athi94/sunswift.driver-display/hardware/addl-pcb-flipped.pdf

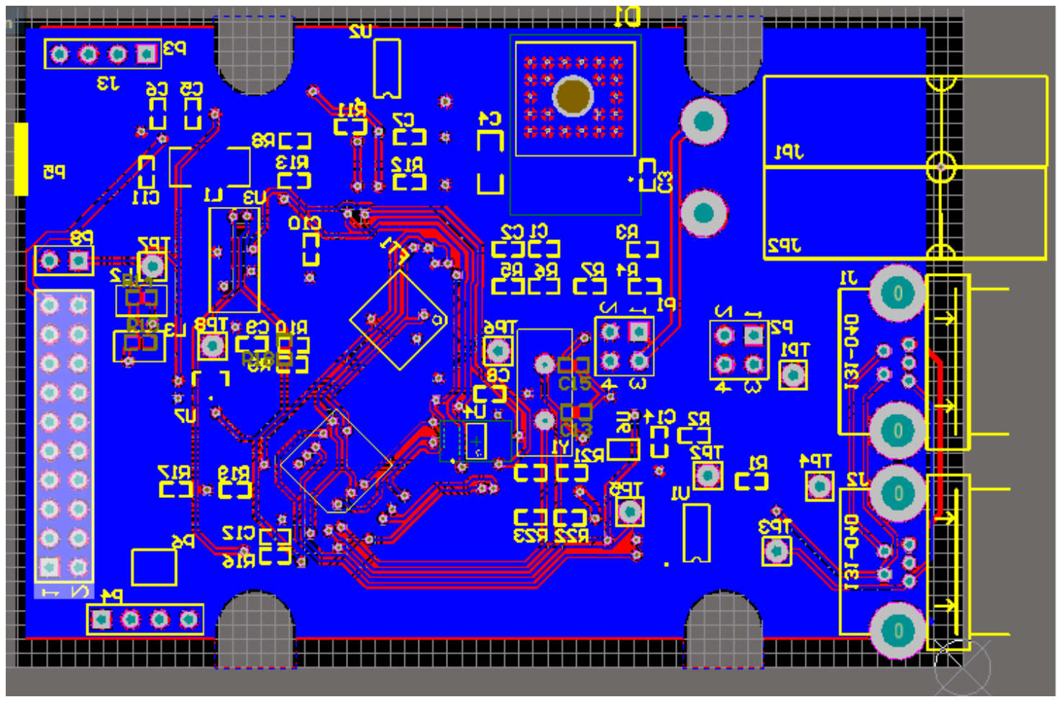
[picture p1: page 1]
