athi94/sunswift.driver-display/hardware/addl-pcb.pdf

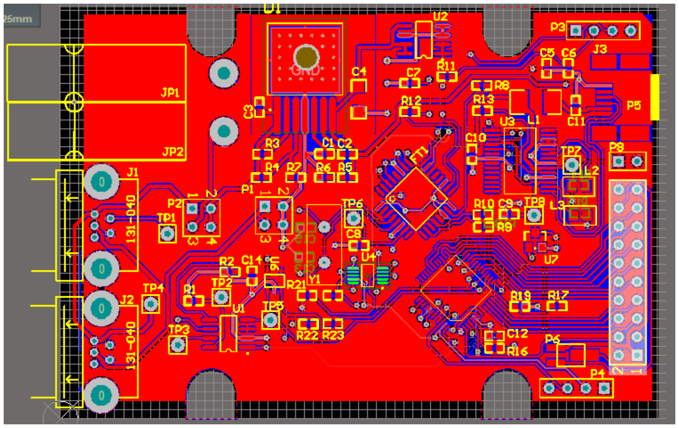
[picture p2: page 1]
