athi94/sunswift.driver-display/hardware/addl-placement-v1-20130409.bmp

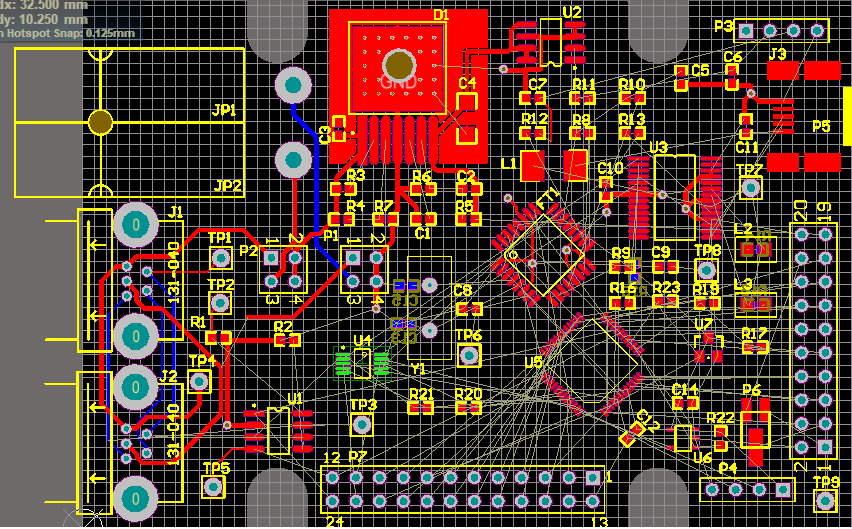
hardware/addl-placement-v1-20130409.bmp
