athi94/sunswift.driver-display/hardware/bom/bom.xlsx

Sheet: combined-20130705
Comment | Description | Footprint | LibRef | Quantity/board | Quantity for 3 boards each | Status
CAP | Ceramic Capacitor (100uF) | 1206 | CAP | 3 | 9 | Not in Inventory
CAP | Capacitor (10uF) | 1206 |  | 1 | 3 | Not in Inventory
INDUCTOR | Inductor | 1812 | INDUCTOR | 2 | 6 | Not in Inventory
Male Break away Headers | Male Break away Headers | - | - | 3 | 9 | Not in Inventory
Female Breakaway headers | Female Breakaway headers | - | - | 3 | 9 | Not in Inventory
MIC5200 | MIC5200 - SO8 | SO8 | MIC5200 | 1 | 3 | Not in Inventory
Dual Analog Switches for FT311D signals selection | Ultra-low resistance dual SPDT Analog switch | MICRO10 | NLAS4684 | 3 | 9 | Not in Inventory
24AAXX | I2C EEPROM for SOT23-5 package | SOT23-5 | 24AAXX | 2 | 6 | Not in Inventory
XC61CN2002MR | SOT23 reset generator | SOT23-3 | XC61F | 2 | 6 | Not in Inventory
XBEE HEADERS | 2mm spacing, 20 pins headers for xbee | XBEE_HEADER | XBEE PRO 900HP | 2 | 6 | Not in Inventory
Male Right angle headers required (6x) 1x20 each |  | - | - | 2 | 6 | Not in Inventory
SD card data logger from sparkfun |  | - | - | 1 | 3 | Not in Inventory

Sheet: driver-display-20130705
Comment | Description | Designator | Footprint | LibRef | Quantity | Status
~~CAP~~ | ~~Capacitor~~ | ~~C1, C2, C3, C5, C6, C7, C8, C9, C10, C11, C12, C13, C14, C15, C16, C17, C18~~ | ~~603~~ | ~~CAP, CAP1~~ | ~~17~~ | ~~In Inventory~~
CAP | Capacitor | C4 | 1206 | CAP | 1
~~DC-DC SWITCHER~~ | ~~DC-DC SWITCHER~~ | ~~D1~~ | ~~PFM-7~~ | ~~lmz12001~~ | ~~1~~ | ~~In Inventory~~
~~FT311D~~ | ~~USB ANDROID Host IC~~ | ~~FT1~~ | ~~QFP32~~ | ~~FT311D~~ | ~~1~~ | ~~Not required atm~~
~~HOLE~~ | ~~Hole~~ | ~~H2, H4~~ | ~~M2.5~~ | ~~HOLE~~ | ~~2~~ | ~~Not part~~
~~CON5-S~~ | ~~Connector, 2 pin, with shield @ S~~ | ~~J1, J2~~ | ~~TRIAD5F~~ | ~~CON5-S~~ | ~~2~~ | ~~Getting for free and salvaged some?~~
~~USB_MINIB~~ | ~~USB Mini B Connector~~ | ~~J3~~ | ~~USBMINIB~~ | ~~USB_miniB_SMT~~ | ~~1~~ | ~~In Inventory~~
~~PGND~~ | ~~Power Ground (currently assumed that it is provided through a min-anderson connector)~~ | ~~JP1~~ | ~~POWERPOLE25A~~ | ~~CON1~~ | ~~1~~ | ~~In Inventory~~
~~CON1~~ | ~~Currently assumed that the mini-anderson connector provides 12V~~ | ~~JP2~~ | ~~POWERPOLE25A~~ | ~~CON1~~ | ~~1~~ | ~~In Inventory~~
INDUCTOR | Inductor | L1 | 1812 | INDUCTOR | 1
~~LED~~ |  | ~~L2, L3~~ | ~~0805LED~~ | ~~LED~~ | ~~2~~ | ~~In Inventory~~
~~LED for Blink Testing~~ |  | ~~L4~~ | ~~0805LED~~ | ~~LED~~ | ~~1~~ | ~~In Inventory~~
Header 2X2 | Header, 2-Pin, Dual row | P1, P2 | HDR2X2 | Header 2X2 | 2
Header 4 | Header, 4-Pin | P3, P4 | HDR1X4 | Header 4 | 2
~~RES1~~ | ~~Resistor~~ | ~~R1, R3, R4, R5, R6, R7, R9, R12, R13, R14, R15, R20, R21, R24, R25~~ | ~~603~~ | ~~RES1~~ | ~~15~~ | ~~In Inventory~~
~~For normal operation, ground AB. To implement autobaud, pull AB high.~~ | ~~Resistor~~ | ~~R2~~ | ~~603~~ | ~~RES1~~ | ~~1~~ | ~~In Inventory~~
~~Leave Open for SPI(Slave)~~ | ~~Resistor~~ | ~~R8~~ | ~~603~~ | ~~RES1~~ | ~~1~~ | ~~In Inventory~~
~~Leave open for UART~~ | ~~Resistor~~ | ~~R10~~ | ~~603~~ | ~~RES1~~ | ~~1~~ | ~~In Inventory~~
~~27~~ | ~~Resistor~~ | ~~R11~~ | ~~603~~ | ~~RES1~~ | ~~1~~ | ~~In Inventory~~
~~Res Semi~~ | ~~Semiconductor Resistor~~ | ~~R16, R17, R18, R19, R22, R23~~ | ~~603~~ | ~~Res Semi~~ | ~~6~~ | ~~In Inventory~~
TP_CAN_SIG | TEST POINT for 12V on CAN | TP1 | TESTPOINT | TEST | 1
TEST | TEST POINT | TP2 | TESTPOINT | TEST | 1
TP_CAN_H | TEST POINT | TP3 | TESTPOINT | TEST | 1
TP_RX | TEST POINT | TP5 | TESTPOINT | TEST | 1
TP_AVCC | TEST POINT | TP6 | TESTPOINT | TEST | 1
TP_USB5V | TEST POINT | TP7 | TESTPOINT | TEST | 1
TP_USB3V3 | TEST POINT | TP8 | TESTPOINT | TEST | 1
SN65HVD235. LPC can pull Rs Hi for standby mode | 3.3V CAN XCVR W/STANDBY | U1 | SO8 | SN65HVD235 | 1 | In Inventory
MIC5200 | MIC5200 - SO8 | U2 | SO8 | MIC5200 | 1
FT232R |  | U3 | SSOP28w | FT232R | 1 | In Inventory
Dual Analog Switches for FT311D signals selection | Ultra-low resistance dual SPDT Analog switch | U4 | MICRO10 | NLAS4684 | 2
LPC11C14 | NXP LPC11C14 Microcontroller | U5 | QFP48 | LPC11C14_Full | 1 | In Inventory
24AAXX | I2C EEPROM for SOT23-5 package | U6 | SOT23-5 | 24AAXX | 1
XC61CN2002MR | SOT23 reset generator | U7 | SOT23-3 | XC61F | 1
12 MHz | Crystal | Y1, Y2 | HC49/4H | CRYSTAL | 2 | In Inventory

Sheet: telemetry-20130705
Comment | Description | Designator | Footprint | LibRef | Quantity | Status
~~CAP~~ | ~~Capacitor~~ | ~~C1, C2, C6, C7, C8, C9, C10, C11~~ | ~~603~~ | ~~CAP~~ | ~~8~~ | ~~In Inventory~~
CAP | Capacitor | C3, C4 | 1206 | CAP | 2
~~100nF~~ | ~~Capacitor~~ | ~~C5, C12, C13, C14~~ | ~~603~~ | ~~CAP~~ | ~~4~~ | ~~In Inventory~~
~~DC-DC SWITCHER~~ | ~~DC-DC SWITCHER~~ | ~~D1~~ | ~~PFM-7~~ | ~~lmz12001~~ | ~~1~~ | ~~In Inventory~~
HOLE | Hole | H2, H4 | M2.5 | HOLE | 2
~~CON5-S~~ | ~~Connector, 2 pin, with shield @ S~~ | ~~J1, J2~~ | ~~TRIAD5F~~ | ~~CON5-S~~ | ~~2~~ | ~~Salvaged - In Inventory~~
~~USB_MINIB~~ | ~~USB Mini B Connector~~ | ~~J3~~ | ~~USBMINIB~~ | ~~USB_miniB_SMT~~ | ~~1~~ | ~~In Inventory~~
~~CON1~~ | ~~Currently assumed that the mini-anderson connector provides 12V~~ | ~~JP1~~ | ~~POWERPOLE25A~~ | ~~CON1~~ | ~~1~~ | ~~In Inventory~~
~~PGND~~ | ~~Power Ground (currently assumed that it is provided through a min-anderson connector)~~ | ~~JP2~~ | ~~POWERPOLE25A~~ | ~~CON1~~ | ~~1~~ | ~~In Inventory~~
INDUCTOR | Inductor | L1 | 1812 | INDUCTOR | 1
~~LED~~ |  | ~~L2, L3, L4, L5, L6~~ | ~~0805LED~~ | ~~LED~~ | ~~5~~ | ~~In Inventory~~
Header 2X2 | Header, 2-Pin, Dual row | P1, P2 | HDR2X2 | Header 2X2 | 2
Header 10X2 | Header, 10-Pin, Dual row | P3 | HDR2X10 | Header 10x2 | 1
Header 4 | Header, 4-Pin | P4 | HDR1X4 | Header 4 | 1
~~RES1~~ | ~~Resistor~~ | ~~R1, R2, R4, R5, R6, R7, R8, R13, R14, R15, R16, R17, R18, R19, R20, R21, R22~~ | ~~603~~ | ~~RES1~~ | ~~17~~ | ~~In Inventory~~
~~Res Semi~~ | ~~Semiconductor Resistor~~ | ~~R3, R9, R10, R11, R12~~ | ~~603~~ | ~~Res Semi~~ | ~~5~~ | ~~In Inventory~~
TEST | TEST POINT, TEST POINT for 12V on CAN | TP1, TP2, TP4, TP7, TP8 | TESTPOINT | TEST | 5
~~SN65HVD235. pull Rs Hi for standby~~ | ~~3.3V CAN XCVR W/STANDBY~~ | ~~U1~~ | ~~SO8~~ | ~~SN65HVD235~~ | ~~1~~ | ~~In Inventory~~
~~LPC11C14~~ | ~~NXP LPC11C14 Microcontroller~~ | ~~U2~~ | ~~QFP48~~ | ~~LPC11C14_Full~~ | ~~1~~ | ~~In Inventory~~
Dual Analog Switches | Ultra-low resistance dual SPDT Analog switch | U3 | MICRO10 | NLAS4684 | 1
24AAXX | I2C EEPROM for SOT23-5 package | U4 | SOT23-5 | 24AAXX | 1
XC61CN2002MR | SOT23 reset generator | U5 | SOT23-3 | XC61F | 1
FT232R |  | U6 | SSOP28w | FT232R | 1
XBEE HEADERS | 2mm spacing, 20 pins headers for xbee | XB1 | XBEE_HEADER | XBEE PRO 900HP | 2
~~12 MHz~~ | ~~Crystal~~ | ~~Y1~~ | ~~HC49/4H~~ | ~~CRYSTAL~~ | ~~1~~ | ~~In Inventory~~
