athi94/sunswift.driver-display/hardware/driver-display.pdf

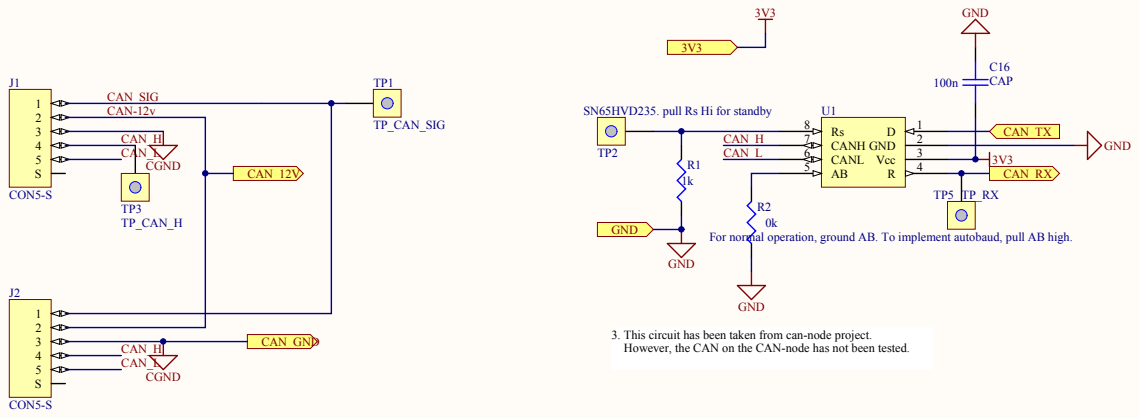
[picture p4: page 1]

on, ground AB. To implement autobaud, pull AB high.

3. This circuit has been tak
However, the CAN on the CAN-node has not been tested

en from can-node project.

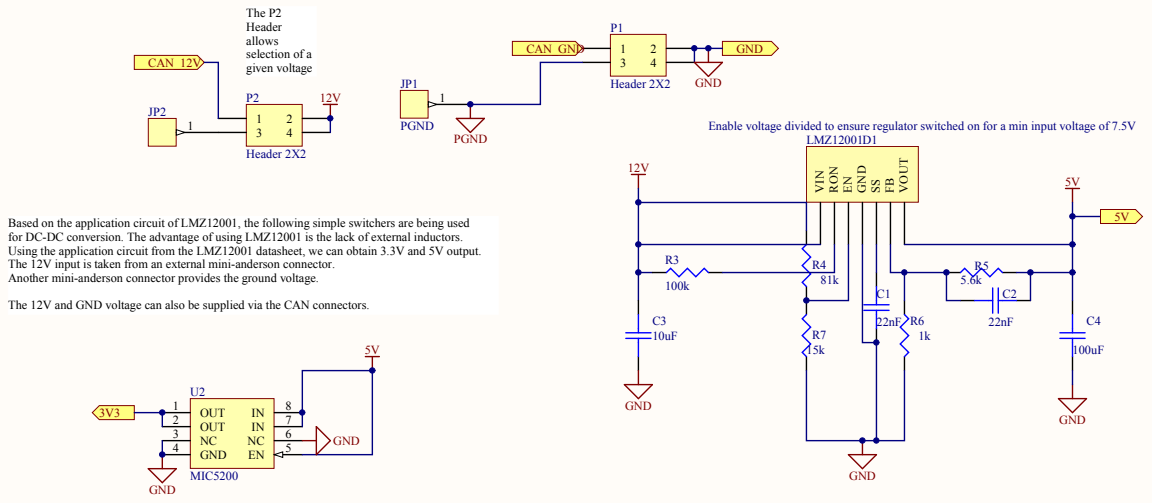
[picture p5: page 2]

Enable voltage divided to ensure regulator switched on for a min input voltage of 7.5V

Based on the application circuit of LMZ12001, the following simple switchers are being used
for DC-DC conversion. The advantage of using LMZ12001 is the lack of external inductors.
Using the application circuit from the LMZ12001 datasheet, we can obtain 3.3V and 5V output.
The 12V input is taken from an external mini-anderson connector.
Another mini-anderson connector provides the ground voltage.

The 12V and GND voltage can also be supplied via the CAN connectors.

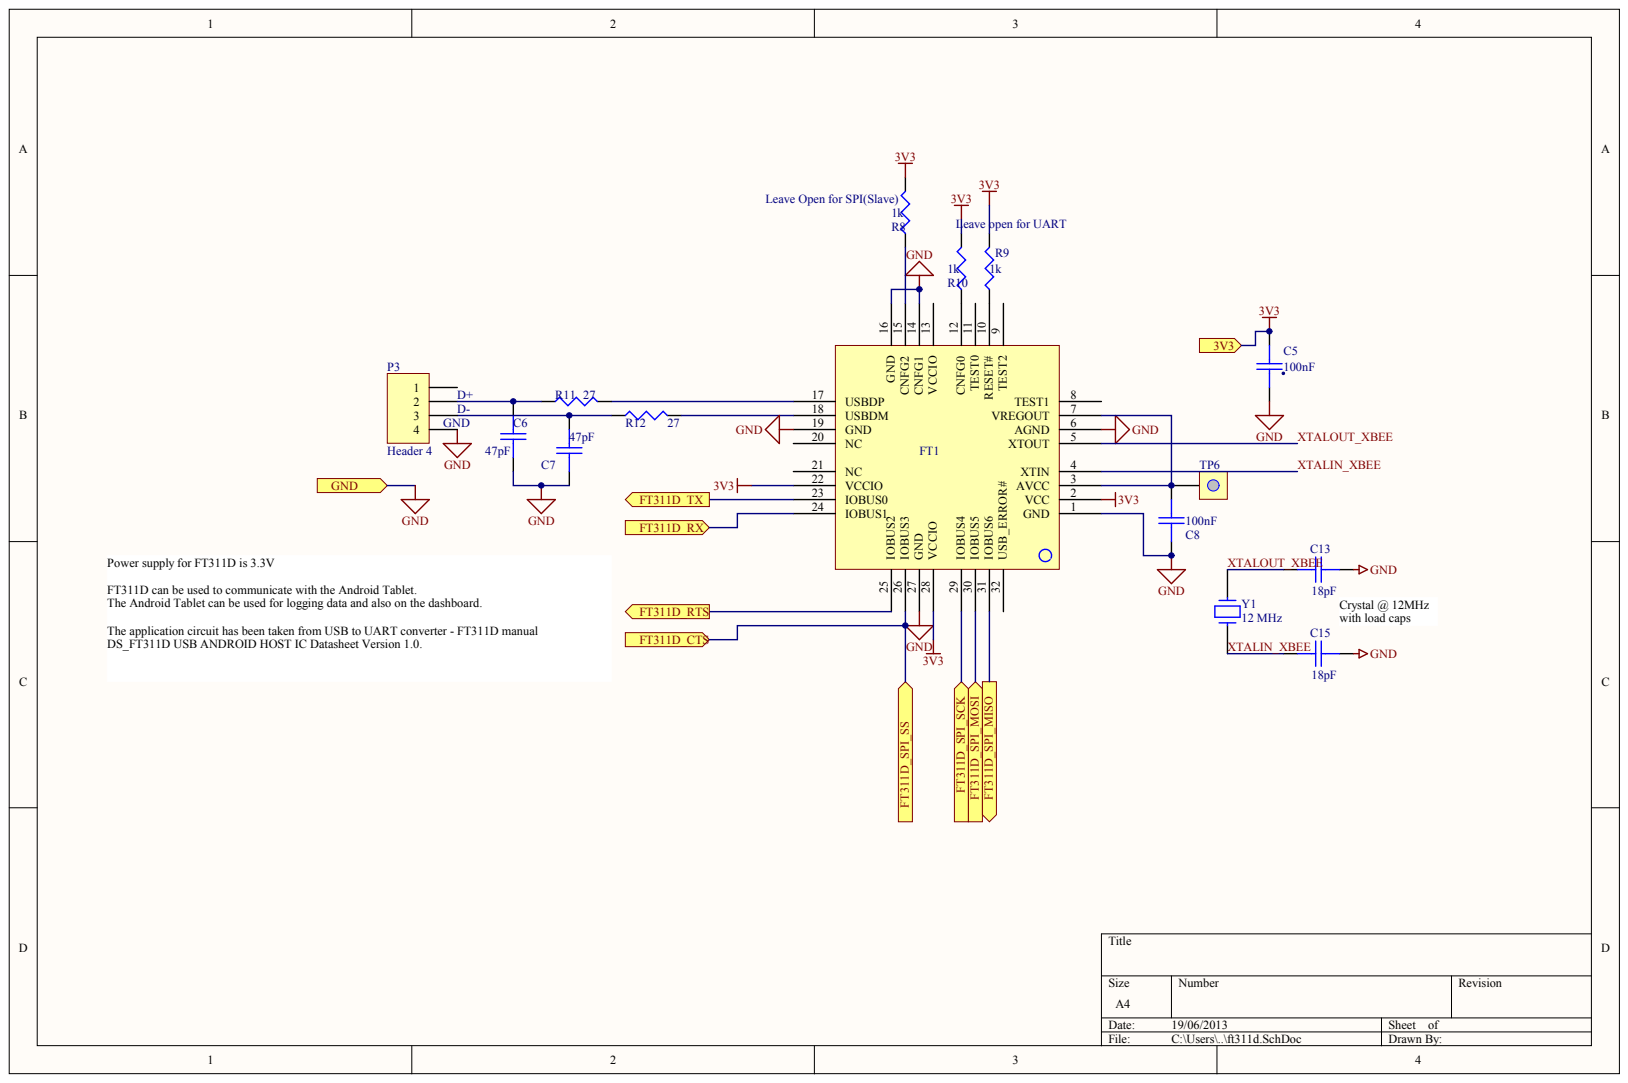
[picture p6: page 3]

Power supply for FT311D is 3.3V FT311D can be used to communicate with

The Android Tablet can be used for lo

a and also on the dashboard.

The application circuit has been ta
FT311D USB ANDROID HOST IC Datasheet Version 1.0

en from USB to UART con

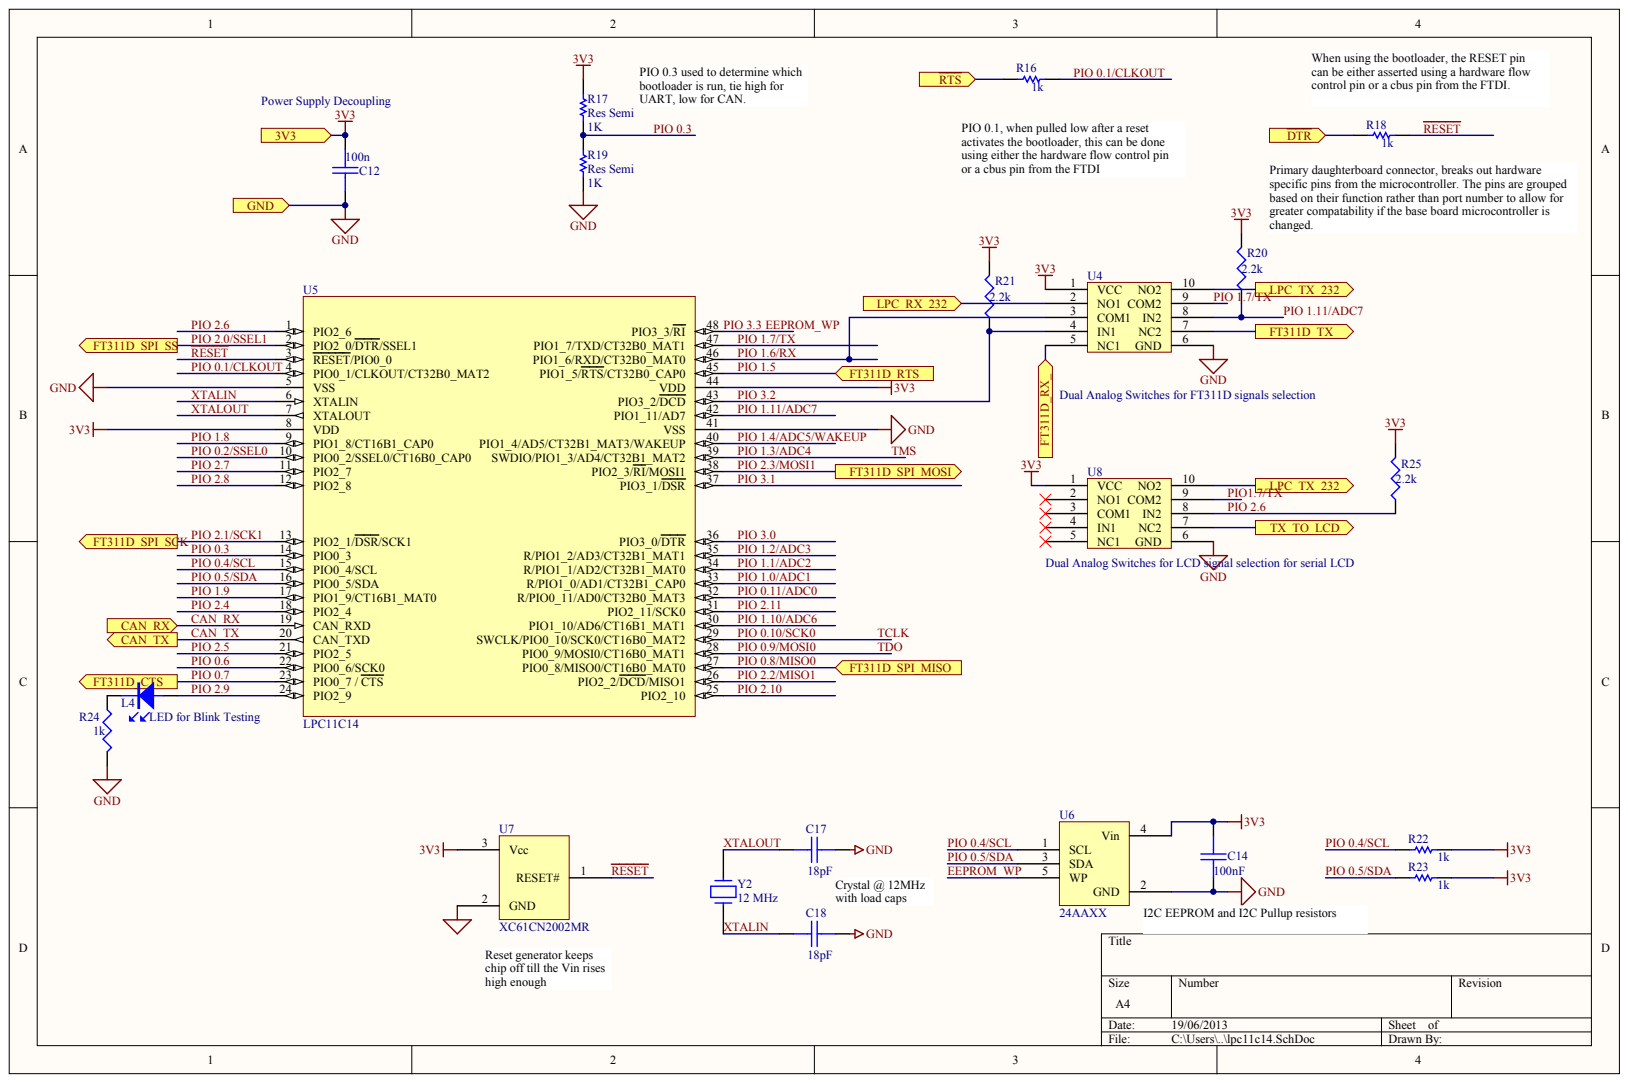
[picture p7: page 4]

hen usin
can be either asserted using a hardware flow
control pin or a cbus pin from the FTDI.

g the bootloader, the RESET pin

PIO 0.3 used to determine which
bootloader is run, tie high for
UART,

PIO 0.1, when pull
activ
using either the hardware flow control pin
or a cbus p

ates the bootloader, this can be done

Primary daug
specific pins
based on their function rather than port number to a
er compatability if the base board microcontroller is
grea
chan

from the microcontroller. The pins are grouped

PIO 0.1/CLKOUT PIO 1.8 PIO 0.2/SSEL0 PIO 2.7 PIO 2.8 PIO 2.1/SCK1 PIO 0.3 PIO 0.4/SCL PIO 0.5/SDA PIO 1.9 PIO 2.4

PIO 3.3 PIO 1.7/TX PIO 1.6/RX PIO 1.5 PIO 3.2 PIO 1.4/ADC5/W
PIO 0.9/MOSI0 PIO 0.8/MISO0 PIO 1.2/ADC3 PIO 1.0/ADC1 PIO 1.1/ADC2 PIO 1.10/ADC6 PIO 1.11/ADC7

PIO 2.3/MOSI1 PIO 3.1 PIO 3.0 PIO 0.11/ADC0 PIO 2.11 PIO 2.2/MISO1 PIO 2.10

CAN_RX
CAN_TX PIO 2.5 PIO 0.6 PIO 0.7 PIO 2.9

I2C EEPROM and I2C Pullup resistors

or keeps
ff till the Vin rises
hig

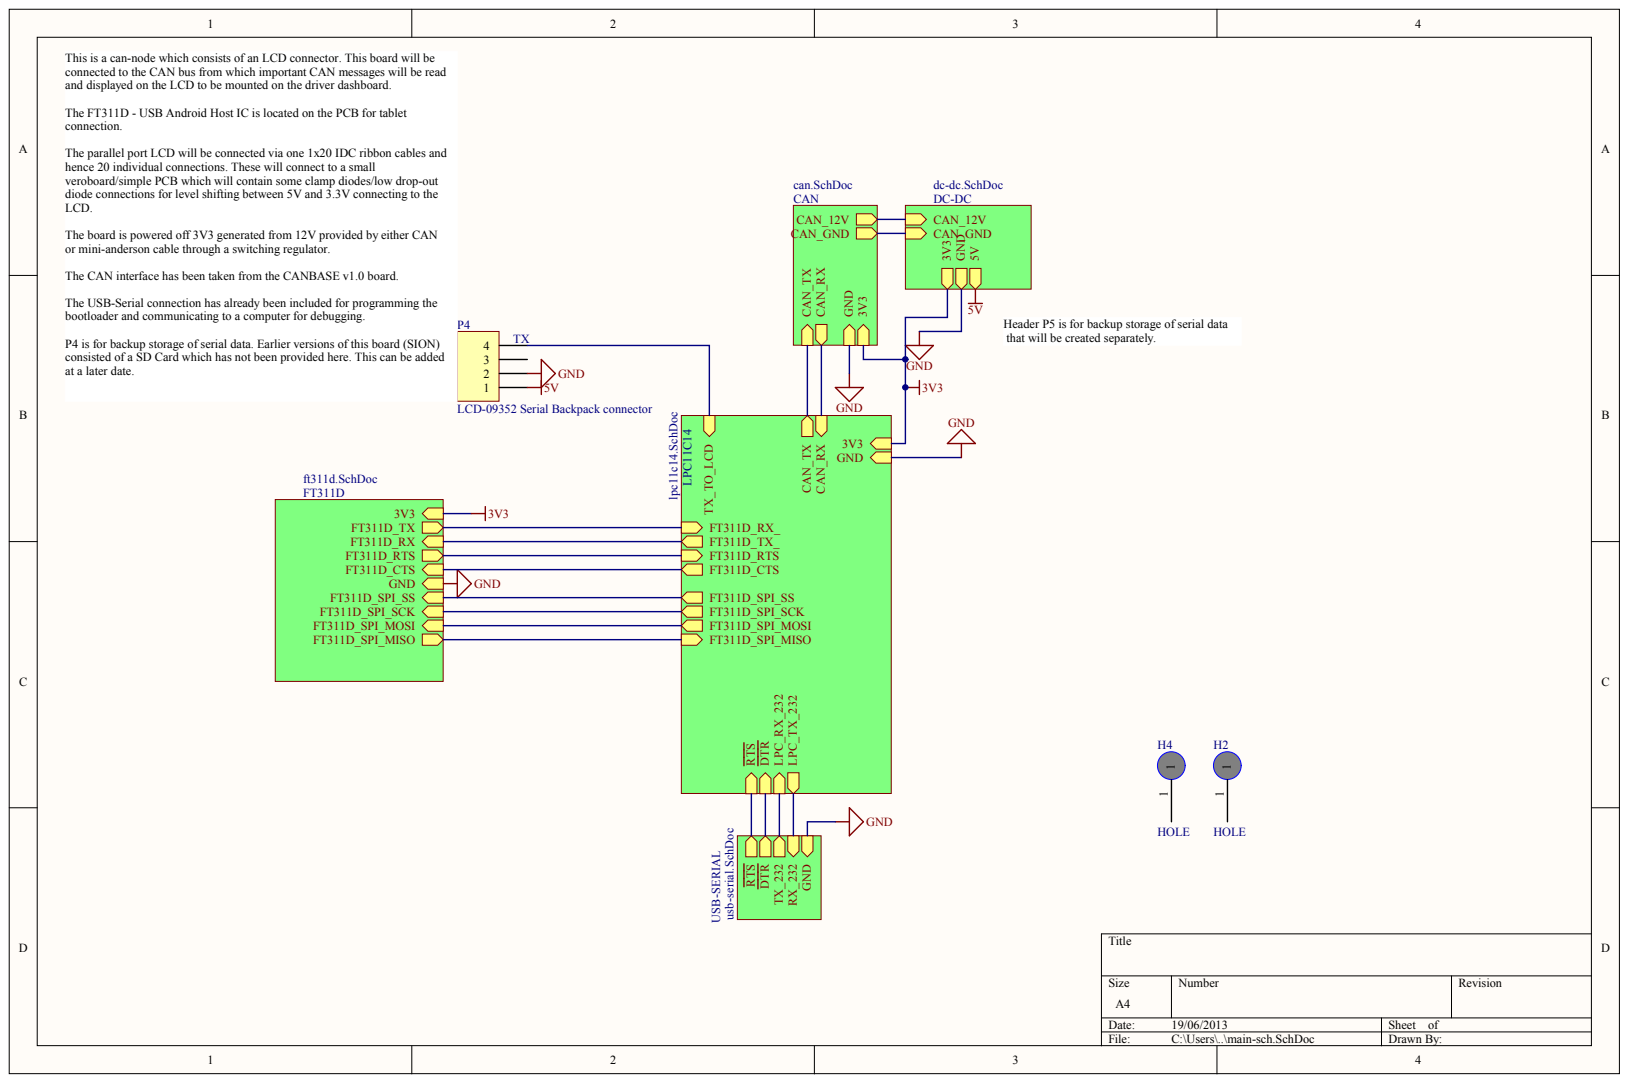
[picture p8: page 5]

This is a can-node which consists of an LCD connector. This board will be
connected to the CAN bus
and display

from which important CAN messages will be read

ed on the LCD to be mounted on the driver dashboard.

The FT311D - USB Android Host IC is located on the PCB for tablet
connection.

The paralle
hence 20 individual connections. These will connect to a small veroboard/simple PCB which will contain some clamp diodes/low drop-out

l port LCD will be connected via one 1

20 IDC ribbon cables and

The board is powered o
or mini-anderson cable throu

The CAN interface has been taken from the CANBA

The USB-S
bootloader and communicating to a computer for debug

erial connection has already been included

Header P5 is for backup storage o

consisted of a SD Card which has not been pro
at a later date.

f serial data. Earlier versions of this board (SION)

vided here. This can be added

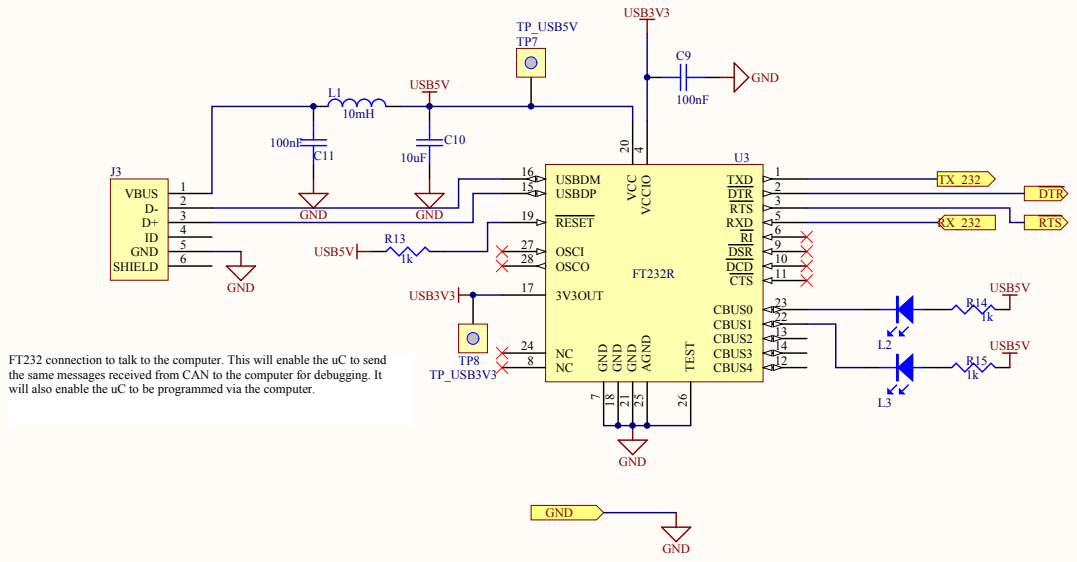
[picture p9: page 6]

USBDP 15

OSCI 27

FT232 connection to talk to the computer. This will enable the uC to send
the same messages received from CAN to the computer for debugging. It
will also enable the uC to be programmed via the computer.

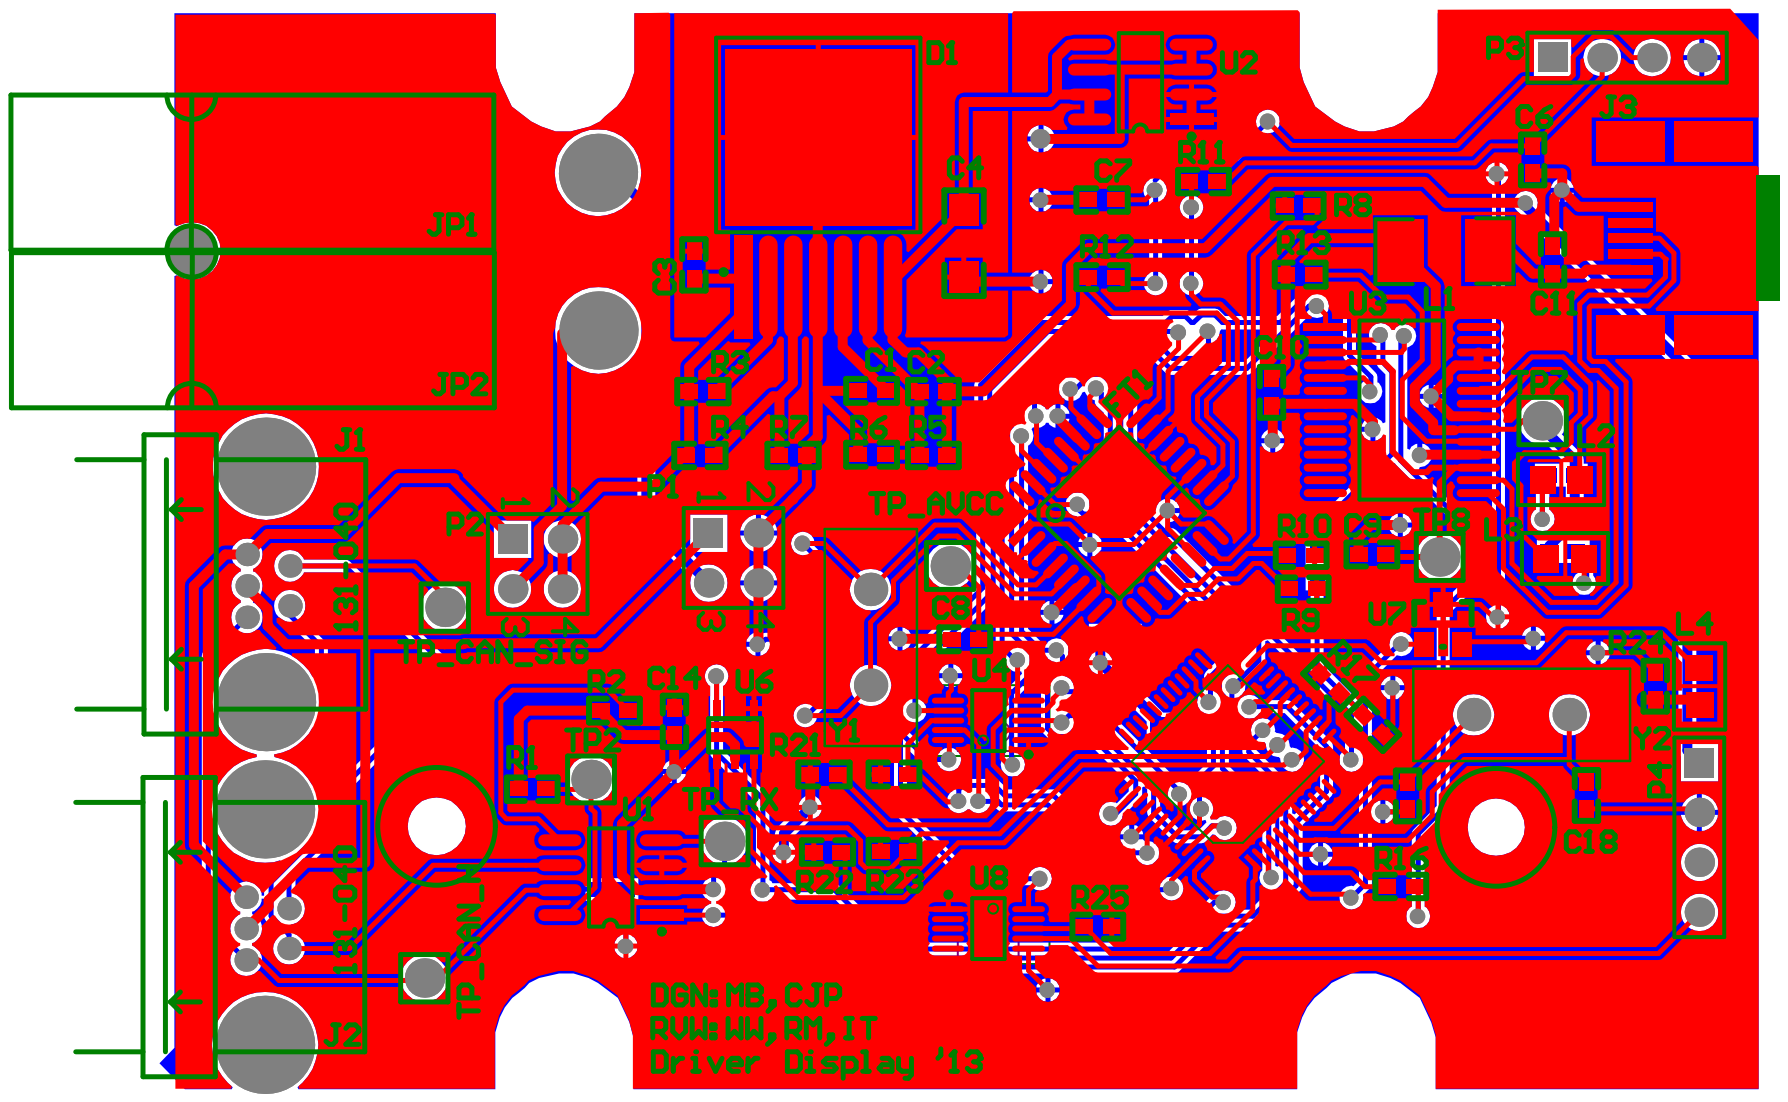
[picture p10: page 7]

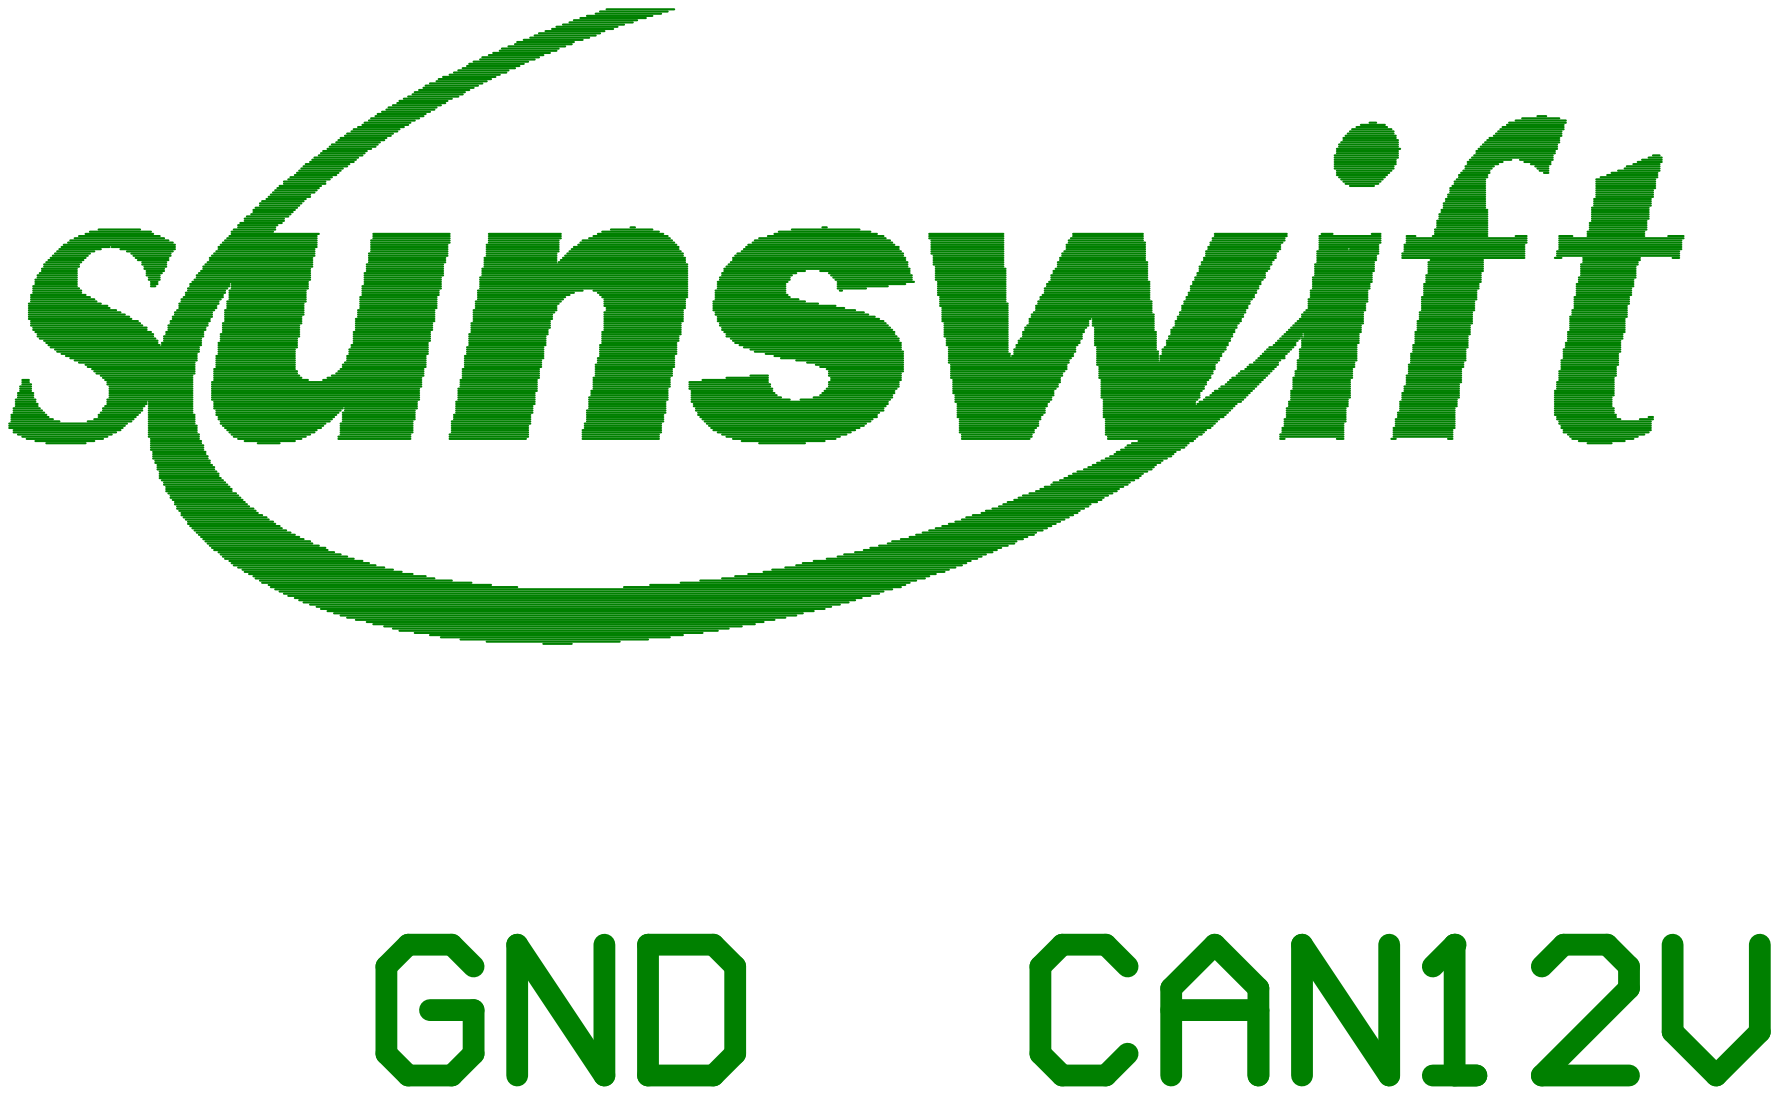
[picture p11: page 8]

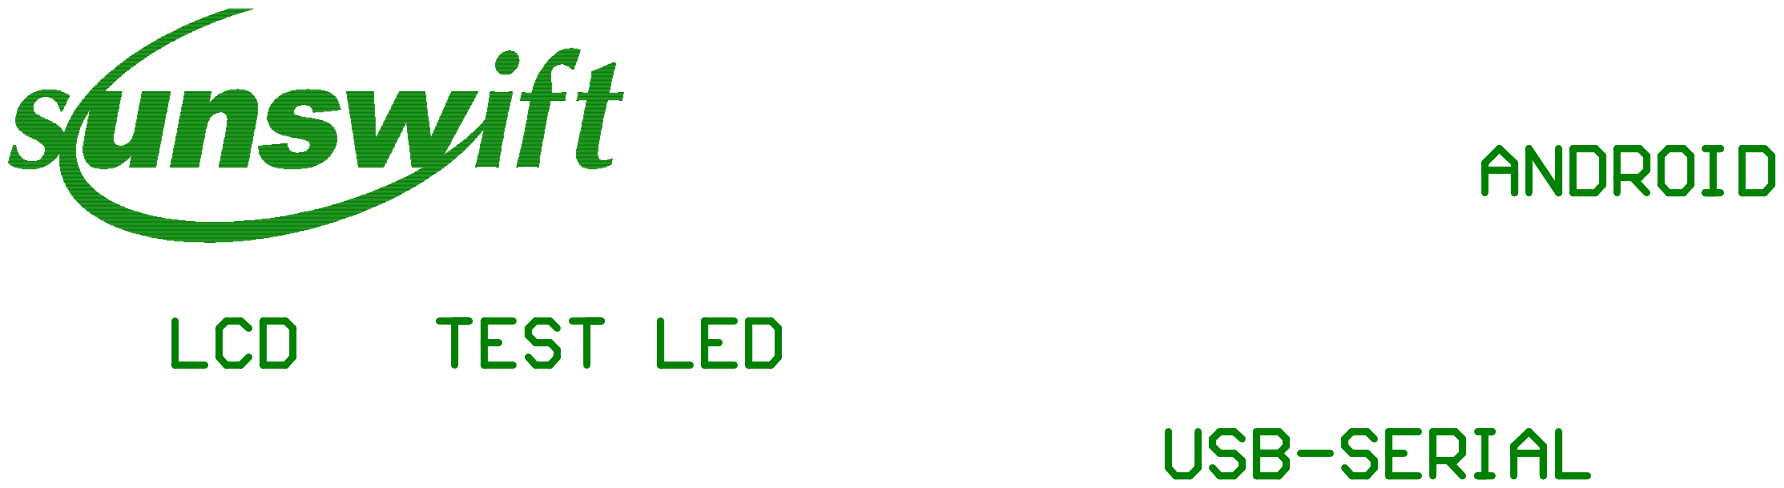
[picture p12: page 9]

Bill of Materials | <Parameter Title not found>
Source Data From: | addl.PrjPcb
Project: | | addl.PrjPcb
Variant: | | None
Creation Date: 19/06/2013 | 12:25:01 AM
Print Date: | 41444 | 41444.01743
Footprint | Comment | LibRef | Designator | Description | Quantity
| | | C11, C12, C13, C14, C15, C16, C17, C18
0603 | CAP | CAP, CAP1 | C1, C2, C3, C5, C6, C7, C8, C9, C10,
Capacitor | 17
1206 | CAP | CAP | C4 | Capacitor | 1
PFM-7 | DC-DC
| SWITCHER | lmz12001 | D1 | DC-DC SWITCHER | 1
QFP32 | FT311D | FT311D | FT1 | USB ANDROID Host IC | 1
M2.5 | HOLE | HOLE | H2, H4 | Hole | 2
TRIAD5F | CON5-S | CON5-S | J1, J2 | Connector, 2 pin, with shield @ S | 2
USBMINIB | USB_MINIB | USB_miniB_SM
| | T | J3 | USB Mini B Connector | 1
POWERPOL E25A | PGND | CON1 | JP1 | Power Ground (currently assumed that it is
| | | | provided through a min-anderson
| | | | connector) | 1

POWERPOL
E25A
| CON1 | CON1 | JP2 | Currently assumed that the mini-anderson
| | | | connector provides 12V | 1
1812 | INDUCTOR | INDUCTOR | L1 | Inductor | 1
0805LED | LED | LED | L2, L3 | | 2
0805LED | LED for Blink
| Testing | LED | L4 | | 1
HDR2X2 | Header 2X2 | Header 2X2 | P1, P2 | Header, 2-Pin, Dual row | 2
HDR1X4 | Header 4 | Header 4 | P3, P4 | Header, 4-Pin | 2
0603 | RES1 | RES1 | R1, R3, R4, R5, R6, R7, R9, R12, R13,
| | | R14, R15, R20, R21, R24, R25 | Resistor | 15
0603 | For normal
| operation,
| ground AB. To
| implement
| autobaud, pull
| AB high. | RES1 | R2 | Resistor | 1
0603 | Leave Open for
| SPI(Slave) | RES1 | R8 | Resistor | 1
0603 | Leave open for
| UART | RES1 | R10 | Resistor | 1
0603 | 27 | RES1 | R11 | Resistor | 1
0603 | Res Semi | Res Semi | R16, R17, R18, R19, R22, R23 | Semiconductor Resistor | 6
TESTPOINT | TP_CAN_SIG | TEST | TP1 | TEST POINT for 12V on CAN | 1
TESTPOINT | TEST | TEST | TP2 | TEST POINT | 1
TESTPOINT | TP_CAN_H | TEST | TP3 | TEST POINT | 1
TESTPOINT | TP_RX | TEST | TP5 | TEST POINT | 1
TESTPOINT | TP_AVCC | TEST | TP6 | TEST POINT | 1
TESTPOINT | TP_USB5V | TEST | TP7 | TEST POINT | 1
TESTPOINT | TP_USB3V3 | TEST | TP8 | TEST POINT | 1
SO8 | SN65HVD235.
| pull Rs Hi for
| standby | SN65HVD235 | U1 | 3.3V CAN XCVR W/STANDBY | 1
SO8 | MIC5200 | MIC5200 | U2 | MIC5200 - SO8 | 1
SSOP28w | FT232R | FT232R | U3 | | 1
Micro10 | Dual Analog
| Switches for
| FT311D signals
| selection | NLAS4684 | U4 | Ultra-low resistance dual SPDT Analog
| | | | switch | 1
QFP48 | LPC11C14 | LPC11C14_Full | U5 | NXP LPC11C14 Microcontroller | 1
SOT23-5 | 24AAXX | 24AAXX | U6 | I2C EEPROM for SOT23-5 package | 1
SOT23-3 | XC61CN2002MR | XC61F | U7 | SOT23 reset generator | 1
Micro10 | Dual Analog
| Switches for
| LCD signal
| selection for
| serial LCD | NLAS4684 | U8 | Ultra-low resistance dual SPDT Analog
| | | | switch | 1
HC49/4H | 12 MHz | CRYSTAL | Y1, Y2 | Crystal | 2
| | | | | 77
Approved | | Notes
