athi94/sunswift.driver-display/(list of files, drawings)

Other design files:
hardware/add-pcb-library.PcbLib
hardware/add-schematic-library.SchLib
hardware/addl.PcbDoc
hardware/addl.PrjPcb
hardware/addl_faceplate_left.PcbDoc
hardware/addl_faceplate_right.PcbDoc
hardware/can.SchDoc
hardware/dc-dc.SchDoc
hardware/ft311d.SchDoc
hardware/lcd5v.SchDoc
hardware/lcd33.SchDoc
hardware/lcd.SchDoc
hardware/lcd_wt_tr.SchDoc
hardware/lmz12001.PcbLib
hardware/lmz12001.SchLib
hardware/lpc11c14.SchDoc
hardware/lpc11c14_33.SchDoc
hardware/main-sch.SchDoc
hardware/usb-serial.SchDoc
