athi94/sunswift.driver-display/(commit log)

2011-09-13 added initial hardware and subrepos
    [3V-Switcher-50mA.SchDoc, 3V3-CAN-Unisolated.SchDoc, DriverDisplay.PcbLib, driver_display.PcbDoc, driver_display.PrjPcb, driver_display.SchDoc, lcd.SchDoc, lpc11c14.SchDoc]
2011-09-13 added files and libraries to project
    [driver_display.PrjPcb]
2011-09-13 -Fixed swapped CANGND and 3.3V pins on LPC -Moved 7805 and surrounding vias so they no longer collide
    [driver_display.PcbDoc, lpc11c14.SchDoc]
2011-09-13 added UART header and hgignore
    [driver_display.PcbDoc, driver_display.SchDoc]
2011-09-22 initial firmware for driver display
2013-09-22 Updated code. Graphic LCD display.
    [3V-Switcher-50mA.SchDoc, 3V3-CAN-Unisolated.SchDoc, DriverDisplay.PcbLib, add-pcb-library.PcbLib, add-schematic-library.SchLib, addl.PcbDoc, addl.PrjPcb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]
